gennartan/ergodox-rp2350/hardware/mechanical/README.md

# Hardware

This contains the STL files for the right hand only. For the left hand PCB, simply mirror the design.

The original files comes from [PrintDox Ergodox Case by AGuyFromOhio][https://www.thingiverse.com/thing:2533064]. These were modified to increase the holes size of the USB and completely match this project hardware.
