gennartan/ergodox-rp2350/docs/keyboard-configuration.md

# Keyboard configuration formats

The USB-connected half is the master. It owns a configuration for both hands,
resolves actions, and produces HID reports. The slave sends raw hand/key-index
press and release events over UART; it does not load or interpret a layout.
There is no configuration synchronization between halves. If the USB cable is
moved to the other half, that half uses its own saved configuration or factory
fallback.

## RAM

`struct keyboard_config` owns a name, an active layer count (1–8), a default
layer, a saved display-locale identifier, eight macro slots, and a fixed `actions[2][8][38]` table. `struct keyboard_layout` is a
read-only view into that RAM. The table uses 2,432 bytes, and the complete owned
configuration uses 3,122 bytes on the target.

Each naturally aligned action uses four bytes:

| Field | Size | Meaning |
| --- | --- | --- |
| type | 1 byte | Explicit action ID, 0–12 |
| modifier | 1 byte | Keyboard modifier mask; zero for other action types |
| payload | 2 bytes | Keycode, usage, mouse deltas, or target layer |

The master loads and validates once before scanning keys or accepting slave
events. A press checks active layers from highest to lowest, with at most eight
direct table lookups. The selected four-byte action is cached until release, so
releasing a layer key before another key does not change that key's release
behavior. HID aggregation retains the existing fixed scans over 76 key slots.
There is no allocation, decoding, CRC calculation, NVM access, or configuration
store mutex in the key-event path. Hardware latency has not been benchmarked.

The four named factory layers remain defaults; the runtime accepts all eight
layer slots. The C layout files provide a factory fallback rather than the live
runtime table. The offline configurator's C export remains usable for generating
factory defaults.

## NVM binary record, versions 1–5

This is an explicit byte encoding, not a dump of a C structure. All multibyte
integers are little-endian. Signed mouse deltas use two's-complement bytes.
Saves use version 5, including the macro bank and a 128-byte display-locale
trailer. Versions 1–4 remain readable. Locale metadata is restored from versions
2/3; versions 1/4 default to `qwerty`. Older firmware rejects version-5 records,
so export JSON before downgrading firmware.
Unknown versions are rejected.

| Header offset | Size | Field |
| --- | --- | --- |
| 0 | 4 | ASCII magic `EKCF` |
| 4 | 2 | Format version: 1–5 |
| 6 | 2 | Header size, 64 |
| 8 | 4 | Total record length, including header |
| 12 | 1 | Active layer count, 1–8 |
| 13 | 1 | Default layer index, less than layer count |
| 14 | 1 | Hand count, exactly 2 |
| 15 | 1 | Keys per hand, exactly 38 |
| 16 | 32 | NUL-terminated name, at most 31 bytes |
| 48 | 12 | Reserved, zero in versions 1/4/5; 12-byte locale identifier in versions 2/3 |
| 60 | 4 | IEEE CRC-32 of the entire record, treating this field as zero |
| 64 | variable | Four-byte actions, ordered by hand, active layer, key index |

Hand 0 is left; hand 1 is right. Only active layers are serialized. An action is
`[type, modifier, payload0, payload1]`:

| Type | ID | Payload bytes |
| --- | --- | --- |
| Transparent | 0 | `0, 0` |
| None | 1 | `0, 0` |
| Keyboard | 2 | `keycode, 0`; modifiers are in byte 1 |
| Consumer | 3 | 16-bit usage, little-endian |
| System | 4 | 16-bit usage, little-endian |
| Mouse buttons | 5 | 16-bit button mask, little-endian |
| Mouse move | 6 | signed X, signed Y |
| Mouse wheel | 7 | `0`, signed wheel delta |
| Lighting | 8 | 16-bit lighting command, little-endian |
| Momentary layer | 9 | `0`, target layer |
| Toggle layer | 10 | `0`, target layer |
| Default layer | 11 | `0`, target layer |
| Macro | 12 | 16-bit macro slot index, little-endian (versions 3–5 only) |

Unused action fields must be zero. Validation checks action types, supported HID
usage ranges, mouse ranges, lighting commands, and layer references. The maximum
version-5 record size is **3,168 bytes**; four layers use **1,952 bytes**.
Versions 3/4 omit the 128-byte locale trailer; versions 1/2 omit both the
locale trailer and the 544-byte macro bank. Malformed data
never partially replaces the RAM configuration.

Versions 3–5 append a fixed 544-byte macro bank after the actions: eight slots of
68 bytes each. A slot starts with a one-byte step count (0–16) and three zero
reserved bytes, followed by sixteen four-byte steps. A step is
`[modifier, keycode, delay_ms_low, delay_ms_high]`. Unused steps must be zero.
Keys are HID usages 0–101; modifiers are the usual eight-bit keyboard mask;
delays are 0–5,000 ms. An action may only reference a nonempty slot.

Version 5 then appends a fixed 128-byte NUL-terminated display-locale identifier
(up to 127 ASCII characters). Identifiers are lowercase filename stems from the
repository, using letters, digits, underscores or hyphens, starting with a letter
or digit. The default is `qwerty`. This identifier affects only the configurator's
labels; locale documents are not stored in flash and HID behavior is unchanged.

## Macro execution and editing

Left-click a key, choose **Macro (key sequence)**, and select one of eight shared
slots. Add, remove, or reorder up to sixteen taps using the mouse. Each tap has a
key, modifier checkboxes, and an optional delay after release. Apply to preview
and save to keyboard as usual. Editing a slot affects every key that
references it; Cancel or Discard preview does not alter the active configuration.

A macro runs once per physical press, continues after its trigger is released,
and does not repeat while held. Other macro triggers are ignored while one is
running. The executor sends an initial empty keyboard report, then a press and
release for each tap (at least 10 ms between transitions), plus the configured
after-release delay. A zero key with no modifiers can be used as a pause.
Physical keyboard keys/modifiers are temporarily excluded from keyboard reports
while the macro runs; physical state changes are still tracked, and the current
state is restored afterward. A key held across that restoration can register a
new press. Mouse and consumer/system actions continue normally. Failed HID sends
retry the same transition; an unavailable USB interface cancels the macro.
The executor uses delayed work, so delays do not sleep in key-event processing.
Macro output uses the computer's active keyboard locale, just like ordinary keys.

## Flash storage and boot behavior

The application image is limited to `0x000000..0x3fbfff`. A dedicated 16 KiB
`keyboard-config` partition occupies flash offsets `0x3fc000..0x3fffff`, within
the first 4 MiB. These are offsets in the flash device, not CPU addresses.
The board's other image/storage partitions remain untouched.

Zephyr NVS stores the whole binary configuration under record ID 1, across four
4 KiB sectors. The maximum blob fits in one sector with NVS metadata. NVS appends
a record and completes its metadata after writing its data; it also handles
sector recycling and skips unchanged writes. The application CRC covers both
configuration metadata and actions. This avoids a filesystem, per-key records,
and application-managed multi-record transactions.

On master boot or configuration-mode entry:

1. Copy and validate the compiled factory configuration into RAM.
2. Mount NVS and try to load/decode its configuration record.
3. Use the factory configuration if storage is absent, invalid, corrupt, or has
   an unsupported format. Log the reason through RTT.
4. In normal master mode, initialize the runtime with the validated RAM view
   before enabling split reception and GPIO scanning.

`keyboard_config_save()` validates and persists a complete candidate for the
next boot. It is permitted only in configuration mode. It does not replace the
live RAM table, and the web interface uses it for explicit JSON imports. See
[human-readable layout files](layout-json.md).
A save that is interrupted before NVS commits can leave the previous committed
record available; malformed committed records fall back to factory defaults.
Power interruption on physical RP2350 flash still needs hardware testing.

A regular UF2 image does not include the reserved configuration partition, so
reflashing can preserve saved data. A chip erase clears it. Firmware changes
that alter the binary meaning should bump the version and explicitly define compatibility or use the fallback.

## Web viewer and layout transfer

The configurator serves `GET /api/layout` as `application/octet-stream`, using
exactly the binary format above. The response is a snapshot of the active RAM
configuration, not a freshly read NVM record or a saved candidate awaiting
reboot. It is encoded once when configuration mode starts and served as a static
resource, allowing concurrent reads without modifying configuration state.
Viewing uses GET; validated uploads use the separate `POST /api/layout/import`
endpoint described in [the JSON format documentation](layout-json.md).

The maintained HTML, CSS, and JavaScript sources are bundled into a single gzip
HTML response at build time. The page and layout snapshot each need only one request, so a missing stylesheet
cannot leave the keyboard unstyled. Display-label downloads are optional external
requests and do not block loading the saved configuration or live key display. Live key polling then uses the separate
small endpoint described below.
A data-URI favicon avoids an extra automatic request. HTTP capacity supports six
clients, with socket polling sized for all clients plus the listener and eventfd;
network connection/context budgets also include DHCP. TCP windows are capped at
2 KiB per connection within the shared packet-buffer budget.

The embedded HTML/CSS/JavaScript viewer validates the record length, version,
dimensions, and CRC before displaying it. It shows the layout name, default layer,
all available layers, and both physical keyboard halves. Left-clicking a key opens an action editor. Choose the key type and its settings
using dropdowns and modifier/button checkboxes; no keyboard input is needed.
Apply to preview stages the assignment on the selected hand and layer. Cancel
closes the editor without changes. Save to keyboard persists the preview for
the next reboot, and Discard preview restores the current layout. All thirteen
action types are supported, including modifier-only keys and layer switching. Transparent assignments remain explicitly transparent rather
than pretending to resolve all possible combinations of active layers.
The selected display locale is part of the configuration, JSON export, and NVM.
Changing it creates a preview; **Save to keyboard** persists it for the next
reboot. Opening the configurator reads the identifier from the keyboard, so the
same selection is restored on a different computer. Browser preferences never
override the saved selection. Discard preview restores the current locale too.
The browser downloads the GitHub repository tree at revision
`8a391fd41a2b2b77cfab16d7f2e53da09bfe747a` of
[gennartan/layouts](https://github.com/gennartan/layouts) and builds the dropdown
from the available JSON files. Optional `tools/xkb-catalog.tsv` metadata provides
human-readable XKB names. There is no embedded list of locales; inheritance
helpers are excluded from the selector. At this revision there are 710 choices.
Only the chosen mapping and its parents are downloaded; the catalog and mappings
are cached by repository/revision for offline reuse. Downloads go directly from
the browser to GitHub over HTTPS. GitHub API limits, network failures, or unknown
saved identifiers leave the saved preference intact and show US HID fallback
labels with a retry button. If descriptions fail, filename-derived names remain
available. Blocked/full browser storage still allows use within the open page.
Locale documents and the catalog are never bundled in firmware.
Unmodified printable keyboard actions show keycap legends from the repository's
character compositions: base at lower left, Shift at upper left, AltGr at lower
right, and Shift+AltGr at upper right. Parent aliases for remapped positions are
removed before resolving inherited compositions, so an obsolete US symbol is
not shown on a locale-specific key. Only available mappings are drawn; a dotted
underline identifies dead-key accents. Multi-key composed characters and IME
output are not treated as single-key glyphs. Assigned modifier combinations,
modifier-only keys, and special actions keep centered action labels. Tooltips,
key details, and accessible names include the available character levels.
The browser cache includes legends and uses a new schema key, so existing
base-label-only caches are downloaded again once.
The host keyboard language still determines the typed characters.
The physical indices match the offline configurator's geometry.

## Live physical key display

Configuration mode starts the same debounced GPIO scanner as normal keyboard
mode and receives slave events over UART. It routes both to a separate ISR-safe
pressed-key bitmap, bypassing layer interpretation, lighting actions, and HID
report submission. Initial local levels capture a boot chord that is still held.
The slave continues its normal raw-event forwarding; it must not enter
configuration mode itself.

`GET /api/keys` returns a fresh 10-byte `application/octet-stream` snapshot with
`Cache-Control: no-store`. Bit `hand * 38 + key_index` indicates a pressed key,
least-significant bit first. Hand 0 is left; hand 1 is right. The last four bits
are zero. A short spinlock protects updates and the snapshot copy; the HTTP
response uses a separate buffer, so input interrupts cannot modify a response
while it is being sent. No configuration or flash writes are involved.

The browser updates only CSS classes and polls at up to 20 Hz, with at most one
request outstanding. It keeps physical highlights when switching the displayed
layer. Hidden tabs cancel polling and resume with a new snapshot when visible.
Errors or malformed responses clear stale highlights and retry with a delay of
250 ms, doubling up to 2 seconds. Snapshot polling can miss a tap shorter than
the interval between successful samples. UART event loss and reconnect-state
synchronization are not addressed by this HTTP snapshot API.

## Tests

Run the codec/runtime and real NVS backend tests using Zephyr's native simulator:

```sh
docker compose run --rm build west build -b native_sim/native/64 \
  -d /workspace/build/config-tests /workspace/tests/config
docker compose run --rm build sh -c \
  'cd /workspace/build/config-tests && ./zephyr/zephyr.exe'
```

Tests cover round trips, every single-byte corruption, truncation, invalid
configuration values, all eight layers, cross-hand layer resolution, release
semantics, saves/reloads, repeated writes that force NVS sector recycling,
write rejection during normal keyboard mode, and corrupt-record fallback.

With Node.js installed, test the browser decoder, action labels, physical key
indices, and invalid responses:

```sh
node tests/config/test_viewer.js
node tests/config/test_display_layouts.js
node tests/config/test_key_legends.js
```

Verify that the firmware page includes all its assets and runs its inline script
after the document is ready:

```sh
python3 tests/config/test_web_bundle.py
```

Test human-readable JSON interchange and strict validation:

```sh
node tests/config/test_json.js
node tests/config/test_macros.js
```

Exercise the upload callback with fragmented HTTP/1.1 bodies, captured headers,
and completion/abort resets (requires a host C compiler):

```sh
python3 tests/config/test_upload.py
python3 tests/config/test_macro_worker.py
```
