gennartan/ergodox-rp2350/hardware/electronic/production/v1/LeftHand/LeftHand_bom.csv

Designator | Footprint | Quantity | Value | LCSC Part #
C1, C16, C2, C3 | 0402 | 4 | 4.7u | C23733
C10, C11, C12, C13, C14, C15, C17, C18, C19, C6, C7, C8, C9 | 0402 | 13 | 100n | C1525
C20, C21 | 0402 | 2 | 15p | C1548
C4, C5 | 1206 | 2 | 10u | C13585
H99 | ErgoDOXmech | 1 | MECHANICAL
J1, J2 | USB_C_Receptacle_GCT_USB4105-xx-A_16P_TopMnt_Horizontal | 2 | USB_C_Receptacle_USB2.0_16P | C3025063
J3, J5 | PinSocket_1x03_P2.54mm_Horizontal | 2 | Conn_01x03_Pin | C92159
J4 | JST_SH_SM03B-SRSS-TB_1x03-1MP_P1.00mm_Horizontal | 1 | Conn_01x03_MountingPin | C160403
L1 | 0805 | 1 | 3.3u | C1046
R1, R4, R5 | 0402 | 3 | 33 | C25105
R10, R8, R9 | 0402 | 3 | 1k | C11702
R11, R12, R13, R14, R15, R16, R17, R18, R19, R20, R21, R22, R23, R24, R25, R26, R27, R28, R29, R30, R31, R32, R33, R34, R35, R36, R37, R38, R39, R40, R41, R42, R43, R44, R45, R46, R47, R48 | 0402 | 38 | 10k
R2, R3 | 0402 | 2 | 5.1k | C25905
R6 | 0402 | 1 | 0 | C17168
SW1, SW2 | SW_SMD_5x3mm | 2 | SW_Push | C720477
SW10, SW11, SW12, SW13, SW14, SW15, SW16, SW17, SW18, SW19, SW20, SW21, SW22, SW23, SW24, SW25, SW26, SW27, SW28, SW29, SW3, SW30, SW31, SW32, SW33, SW34, SW35, SW36, SW37, SW38, SW39, SW4, SW40, SW5, SW6, SW7, SW8, SW9 | MyCherrySwitch | 38 | SW_Push
U1 | QFN-80-1EP_10x10mm_P0.4mm_EP3.4x3.4mm_ThermalVias | 1 | RP2350B-QFN80 | C42415655
U2 | SOT-223-3_TabPin2 | 1 | NCP1117-3.3_SOT223 | C6186
U3 | SOIC-8_5.3x5.3mm_P1.27mm | 1 | W25Q128JVS | C97521
Y1 | Crystal_SMD_Abracon_ABM8G-4Pin_3.2x2.5mm | 1 | Crystal_GND24 | C20625731
