gennartan/ergodox-rp2350/hardware/mechanical/righthand_plate_2.stl

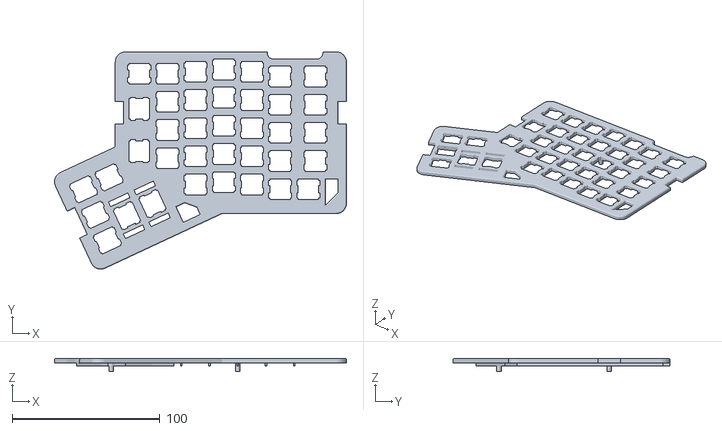
[picture p5: CAD file, 2026-06-07]
hardware/mechanical/righthand_plate_2.stl
197.5 x 146.9 x 8.70
