gennartan/ergodox-rp2350/hardware/mechanical/righthand_top_2.stl

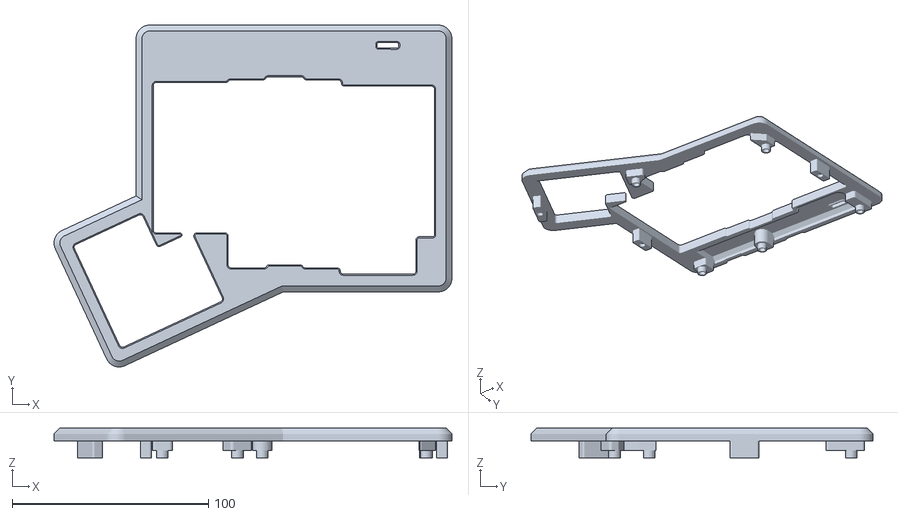
[picture p6: CAD file, 2026-06-07]
hardware/mechanical/righthand_top_2.stl
202.8 x 174.3 x 15.2
