gennartan/ergodox-rp2350/tests/config/fixtures/hid-io/README.md

JSON files and MIT license from https://github.com/gennartan/layouts
Revision: 8a391fd41a2b2b77cfab16d7f2e53da09bfe747a

Test fixtures only; never bundled in firmware.

`repository-tree.json` is the GitHub tree response at this revision. The XKB
catalog, inheritance helpers and representative XKB variants exercise dynamic
discovery and long locale identifiers. Fixtures are never bundled in firmware.
