gennartan/ergodox-rp2350/hardware/electronic/LeftHand.kicad_pcb

## KiCad design hardware/electronic/LeftHand.kicad_pcb (2026-06-07)

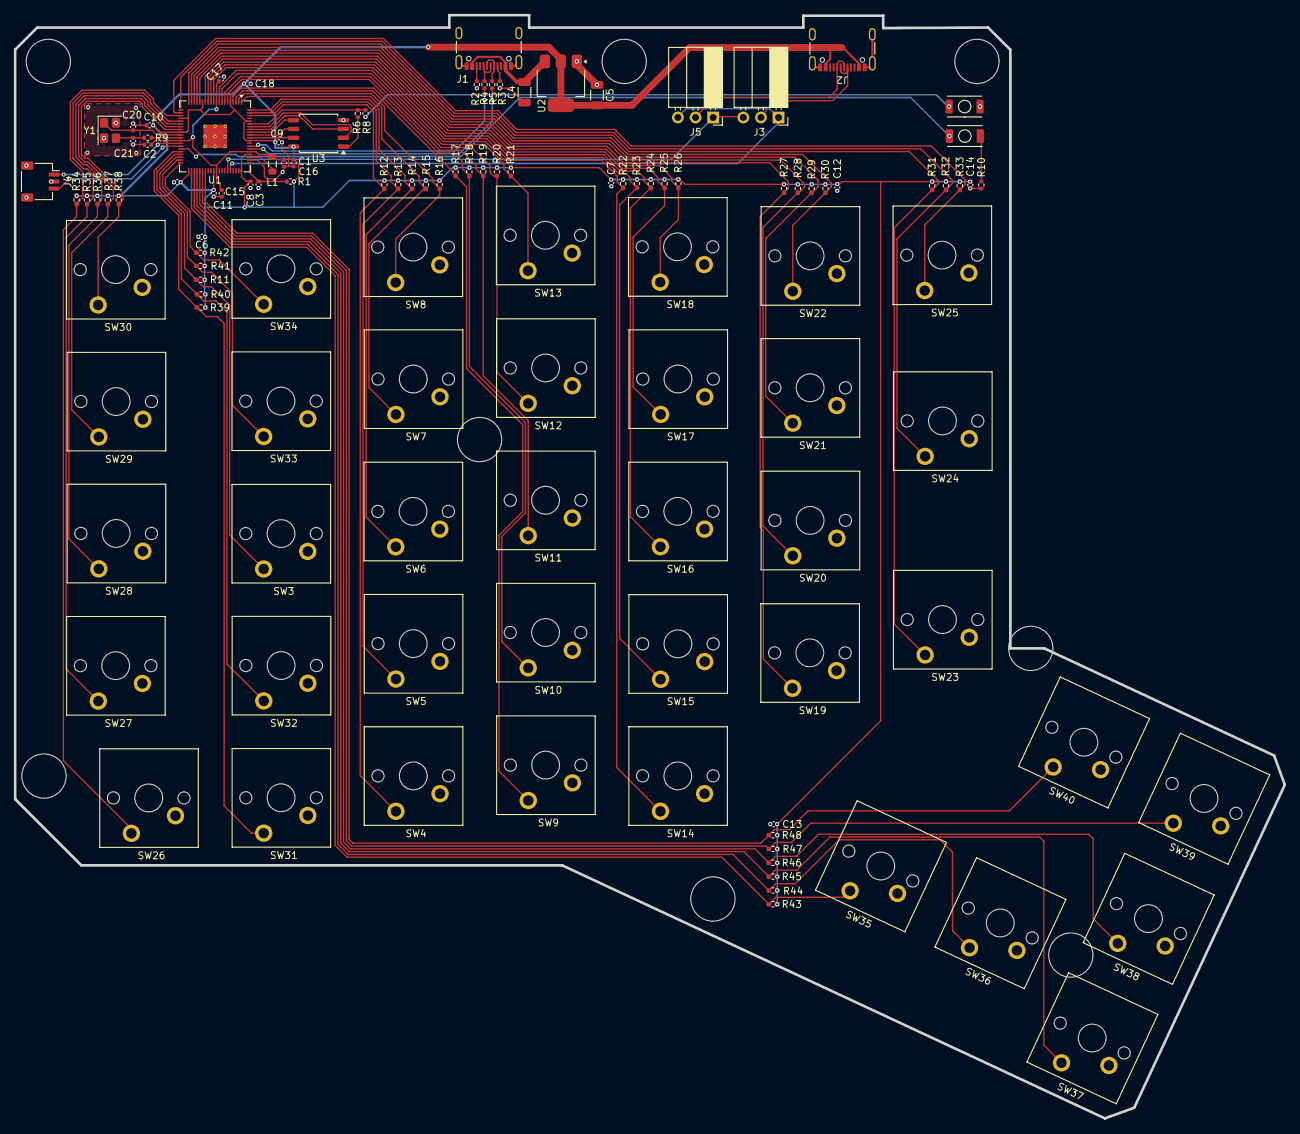
[picture p8: board LeftHand.kicad_pcb from above]

Board: 2 copper layers, 182.8 x 158.9 mm, 119 parts (1 on the bottom side), 69 nets.

Parts:
C1, C2, C3, C16: 4.7u; C_0402_1005Metric
C4, C5: 10u; C_1206_3216Metric
C6, C7, C8, C9, C10, C11, C12, C13, C14, C15, C17, C18, C19: 100n; C_0402_1005Metric
C20, C21: 15p; C_0402_1005Metric
H99: MECHANICAL; ErgoDOXmech
J1, J2: USB_C_Receptacle_USB2.0_16P; USB_C_Receptacle_GCT_USB4105-xx-A_16P_TopMnt_Horizontal
J3, J5: Conn_01x03_Pin; PinSocket_1x03_P2.54mm_Horizontal
J4: Conn_01x03_MountingPin; JST_SH_SM03B-SRSS-TB_1x03-1MP_P1.00mm_Horizontal
L1: 3.3u; L_0805_2012Metric
R1, R4, R5: 33; R_0402_1005Metric
R2, R3: 5.1k; R_0402_1005Metric
R6: 0; R_0402_1005Metric
R8, R9, R10: 1k; R_0402_1005Metric
R11, R12, R13, R14, R15, R16, R17, R18, R19, R20, R21, R22, R23, R24, R25, R26, R27, R28, R29, R30, R31, R32, R33, R34, R35, R36, R37, R38, R39, R40, R41, R42, R43, R44, R45, R46, R47, R48: 10k; R_0402_1005Metric_Pad0.72x0.64mm_HandSolder
SW1, SW2: SW_Push; SW_SMD_5x3mm
SW3, SW4, SW5, SW6, SW7, SW8, SW9, SW10, SW11, SW12, SW13, SW14, SW15, SW16, SW17, SW18, SW19, SW20, SW21, SW22, SW23, SW24, SW25, SW26, SW27, SW28, SW29, SW30, SW31, SW32, SW33, SW34, SW35, SW36, SW37, SW38, SW39, SW40: SW_Push; MyCherrySwitch
U1: RP2350B-QFN80; QFN-80-1EP_10x10mm_P0.4mm_EP3.4x3.4mm_ThermalVias
U2: NCP1117-3.3_SOT223; SOT-223-3_TabPin2
U3: W25Q128JVS; SOIC-8_5.3x5.3mm_P1.27mm
Y1: Crystal_GND24; Crystal_SMD_Abracon_ABM8G-4Pin_3.2x2.5mm

Connections:
+1V1: C2.1, C15.1, C16.1, C17.1, L1.1, U1.10 (DVDD), U1.32 (DVDD), U1.51 (DVDD), U1.65 (VREG_FB)
+3.3V: C1.1, C5.2, C6.1, C7.1, C8.1, C9.1, C10.1, C11.1, C12.1, C13.1, C14.1, C18.1, C19.1, J2.A4 (VBUS), J2.A9 (VBUS), J2.B4 (VBUS), J2.B9 (VBUS), R1.1, R11.1, R12.1, R13.1, R14.1, R15.1, R16.1, R17.1, R18.1, R19.1, R20.1, R21.1, R22.1, R23.1, R24.1, R25.1, R26.1, R27.1, R28.1, R29.1, R30.1, R31.1, R32.1, R33.1, R34.1, R35.1, R36.1, R37.1, R38.1, R39.1, R40.1, R41.1, R42.1, R43.1, R44.1, R45.1, R46.1, R47.1, R48.1, U1.5 (IOVDD), U1.15 (IOVDD), U1.24 (IOVDD), U1.29 (IOVDD), U1.41 (IOVDD), U1.50 (IOVDD), U1.59 (ADC_AVDD), U1.60 (IOVDD), U1.64 (VREG_VIN), U1.68 (USB_OTP_VDD), U1.69 (QSPI_IOVDD), U1.76 (IOVDD), U2.2 (VO), U3.8 (VCC)
/Flash Memory/QSPI_CLK: U1.71 (QSPI_SCLK), U3.6 (CLK)
/Flash Memory/QSPI_SD0: U1.72 (QSPI_SD0), U3.5 (DI/IO_{0})
/Flash Memory/QSPI_SD1: U1.74 (QSPI_SD1), U3.2 (DO/IO_{1})
/Flash Memory/QSPI_SD2: U1.73 (QSPI_SD2), U3.3 (~WP/IO_{2})
/Flash Memory/QSPI_SD3: U1.70 (QSPI_SD3), U3.7 (~HOLD/~RESET/IO_{3})
/Flash Memory/QSPI_SS: R6.1, R8.2, U1.75 (QSPI_SS)
/GPIO1: R12.2, SW4.2, U1.78 (GPIO1)
/GPIO2: R13.2, SW5.2, U1.79 (GPIO2)
/GPIO3: R14.2, SW6.2, U1.80 (GPIO3)
/GPIO4: R15.2, SW7.2, U1.1 (GPIO4)
/GPIO5: R16.2, SW8.2, U1.2 (GPIO5)
/GPIO6: R17.2, SW9.2, U1.3 (GPIO6)
/GPIO7: R18.2, SW10.2, U1.4 (GPIO7)
/GPIO8: R19.2, SW11.2, U1.6 (GPIO8)
/GPIO9: R20.2, SW12.2, U1.7 (GPIO9)
/GPIO10: R21.2, SW13.2, U1.8 (GPIO10)
/GPIO11: R22.2, SW14.2, U1.9 (GPIO11)
/GPIO12: R23.2, SW15.2, U1.11 (GPIO12)
/GPIO13: R24.2, SW16.2, U1.12 (GPIO13)
/GPIO14: R25.2, SW17.2, U1.13 (GPIO14)
/GPIO15: R26.2, SW18.2, U1.14 (GPIO15)
/GPIO16: R27.2, SW19.2, U1.16 (GPIO16)
/GPIO17: R28.2, SW20.2, U1.17 (GPIO17)
/GPIO18: R29.2, SW21.2, U1.18 (GPIO18)
/GPIO19: R30.2, SW22.2, U1.19 (GPIO19)
/GPIO20: R31.2, SW23.2, U1.20 (GPIO20)
/GPIO21: R32.2, SW24.2, U1.21 (GPIO21)
/GPIO22: R33.2, SW25.2, U1.22 (GPIO22)
/GPIO23: R34.2, SW26.2, U1.23 (GPIO23)
/GPIO24: R35.2, SW27.2, U1.25 (GPIO24)
/GPIO25: R36.2, SW28.2, U1.26 (GPIO25)
/GPIO26: R37.2, SW29.2, U1.27 (GPIO26)
/GPIO27: R38.2, SW30.2, U1.28 (GPIO27)
/GPIO28: R39.2, SW31.2, U1.36 (GPIO28)
/GPIO29: R40.2, SW32.2, U1.37 (GPIO29)
/GPIO30: R11.2, SW3.2, U1.38 (GPIO30)
/GPIO31: R41.2, SW33.2, U1.39 (GPIO31)
/GPIO32: R42.2, SW34.2, U1.40 (GPIO32)
/GPIO33: R43.2, SW35.2, U1.42 (GPIO33)
/GPIO34: R44.2, SW36.2, U1.43 (GPIO34)
/GPIO35: R45.2, SW37.2, U1.44 (GPIO35)
/GPIO36: R46.2, SW38.2, U1.45 (GPIO36)
/GPIO37: R47.2, SW39.2, U1.46 (GPIO37)
/GPIO38: R48.2, SW40.2, U1.47 (GPIO38)
/Power/VREG_AVDD: C3.2, R1.2, U1.61 (VREG_AVDD)
/Power/VREG_LX: L1.2, U1.63 (VREG_LX)
/RUN: SW2.2, U1.35 (RUN)
/SWCLK: J4.1, U1.33 (SWCLK)
/SWD: J4.3, U1.34 (SWDIO)
/USB_DN: R5.1, U1.66 (USB_DM)
/USB_DP: R4.1, U1.67 (USB_DP)
GND: C1.2, C2.2, C3.1, C4.1, C5.1, C6.2, C7.2, C8.2, C9.2, C10.2, C11.2, C12.2, C13.2, C14.2, C15.2, C16.2, C17.2, C18.2, C19.2, C20.1, C21.1, J1.A1 (GND), J1.A12 (GND), J1.B1 (GND), J1.B12 (GND), J1.S1 (SHIELD), J2.A1 (GND), J2.A12 (GND), J2.B1 (GND), J2.B12 (GND), J2.S1 (SHIELD), J4.2, J4.MP (MountPin), R2.2, R3.2, R10.2, SW1.1, SW3.1, SW4.1, SW5.1, SW6.1, SW7.1, SW8.1, SW9.1, SW10.1, SW11.1, SW12.1, SW13.1, SW14.1, SW15.1, SW16.1, SW17.1, SW18.1, SW19.1, SW20.1, SW21.1, SW22.1, SW23.1, SW24.1, SW25.1, SW26.1, SW27.1, SW28.1, SW29.1, SW30.1, SW31.1, SW32.1, SW33.1, SW34.1, SW35.1, SW36.1, SW37.1, SW38.1, SW39.1, SW40.1, U1.62 (VREG_PGND), U1.81 (GND), U2.1 (GND), U3.4 (GND), Y1.2, Y1.4
unnamed: C21.2, R9.1, Y1.3
unnamed: J1.A5 (CC1), R3.1
unnamed: J1.B5 (CC2), R2.1
unnamed: J2.A7 (D-), J2.B7 (D-), J3.2
unnamed: J2.A6 (D+), J2.B6 (D+), J5.2
unnamed: R8.1, SW1.2
unnamed: R10.1, SW2.1
unnamed: C20.2, U1.30 (XIN), Y1.1
unnamed: R9.2, U1.31 (XOUT)
unnamed: R6.2, U3.1 (~CS)
UART0_RX: J3.1, J5.3, U1.56 (GPIO45_ADC5)
UART0_TX: J3.3, J5.1, U1.55 (GPIO44_ADC4)
USB_D+: J1.A6 (D+), J1.B6 (D+), R4.2
USB_D-: J1.A7 (D-), J1.B7 (D-), R5.2
VBUS: C4.2, J1.A4 (VBUS), J1.A9 (VBUS), J1.B4 (VBUS), J1.B9 (VBUS), U2.3 (VI)
