gennartan/ergodox-rp2350/src/main.c

#include <string.h>

#include <zephyr/kernel.h>
#include <zephyr/device.h>
#include <zephyr/drivers/gpio.h>
#include <zephyr/usb/usbd.h>
#include <zephyr/usb/class/usbd_hid.h>
#include <zephyr/logging/log.h>

#include "configurator_mode.h"
#include "keyboard_layout.h"
#include "keyboard_config.h"
#include "keyboard_input_state.h"
#include "split_transport.h"

LOG_MODULE_REGISTER(kbd);

#define LEDS 4
#define LED0_NODE DT_ALIAS(led0)
#define LED1_NODE DT_ALIAS(led1)
#define LED2_NODE DT_ALIAS(led2)
#define LED3_NODE DT_ALIAS(led3)

static const struct gpio_dt_spec leds[LEDS] = {
    GPIO_DT_SPEC_GET(LED0_NODE, gpios),
    GPIO_DT_SPEC_GET(LED1_NODE, gpios),
    GPIO_DT_SPEC_GET(LED2_NODE, gpios),
    GPIO_DT_SPEC_GET(LED3_NODE, gpios),
};

#define KEY_DEBOUNCE_MS 5

// Individual key GPIOs for the electronic design
static const struct gpio_dt_spec keys[KEYBOARD_KEY_COUNT] = {
    GPIO_DT_SPEC_GET(DT_NODELABEL(key1), gpios),
    GPIO_DT_SPEC_GET(DT_NODELABEL(key2), gpios),
    GPIO_DT_SPEC_GET(DT_NODELABEL(key3), gpios),
    GPIO_DT_SPEC_GET(DT_NODELABEL(key4), gpios),
    GPIO_DT_SPEC_GET(DT_NODELABEL(key5), gpios),
    GPIO_DT_SPEC_GET(DT_NODELABEL(key6), gpios),
    GPIO_DT_SPEC_GET(DT_NODELABEL(key7), gpios),
    GPIO_DT_SPEC_GET(DT_NODELABEL(key8), gpios),
    GPIO_DT_SPEC_GET(DT_NODELABEL(key9), gpios),
    GPIO_DT_SPEC_GET(DT_NODELABEL(key10), gpios),
    GPIO_DT_SPEC_GET(DT_NODELABEL(key11), gpios),
    GPIO_DT_SPEC_GET(DT_NODELABEL(key12), gpios),
    GPIO_DT_SPEC_GET(DT_NODELABEL(key13), gpios),
    GPIO_DT_SPEC_GET(DT_NODELABEL(key14), gpios),
    GPIO_DT_SPEC_GET(DT_NODELABEL(key15), gpios),
    GPIO_DT_SPEC_GET(DT_NODELABEL(key16), gpios),
    GPIO_DT_SPEC_GET(DT_NODELABEL(key17), gpios),
    GPIO_DT_SPEC_GET(DT_NODELABEL(key18), gpios),
    GPIO_DT_SPEC_GET(DT_NODELABEL(key19), gpios),
    GPIO_DT_SPEC_GET(DT_NODELABEL(key20), gpios),
    GPIO_DT_SPEC_GET(DT_NODELABEL(key21), gpios),
    GPIO_DT_SPEC_GET(DT_NODELABEL(key22), gpios),
    GPIO_DT_SPEC_GET(DT_NODELABEL(key23), gpios),
    GPIO_DT_SPEC_GET(DT_NODELABEL(key24), gpios),
    GPIO_DT_SPEC_GET(DT_NODELABEL(key25), gpios),
    GPIO_DT_SPEC_GET(DT_NODELABEL(key26), gpios),
    GPIO_DT_SPEC_GET(DT_NODELABEL(key27), gpios),
    GPIO_DT_SPEC_GET(DT_NODELABEL(key28), gpios),
    GPIO_DT_SPEC_GET(DT_NODELABEL(key29), gpios),
    GPIO_DT_SPEC_GET(DT_NODELABEL(key30), gpios),
    GPIO_DT_SPEC_GET(DT_NODELABEL(key31), gpios),
    GPIO_DT_SPEC_GET(DT_NODELABEL(key32), gpios),
    GPIO_DT_SPEC_GET(DT_NODELABEL(key33), gpios),
    GPIO_DT_SPEC_GET(DT_NODELABEL(key34), gpios),
    GPIO_DT_SPEC_GET(DT_NODELABEL(key35), gpios),
    GPIO_DT_SPEC_GET(DT_NODELABEL(key36), gpios),
    GPIO_DT_SPEC_GET(DT_NODELABEL(key37), gpios),
    GPIO_DT_SPEC_GET(DT_NODELABEL(key38), gpios),
};

const uint8_t keyboard_hid_report_desc[] = ERGODOX_HID_REPORT_DESC();

static const struct device *keyboard_hid_dev;
static bool keyboard_hid_ready;
static atomic_t hid_protocol = ATOMIC_INIT(HID_PROTOCOL_REPORT);
static uint32_t hid_duration;

USBD_DEVICE_DEFINE(ergodox_usbd,
    DEVICE_DT_GET(DT_NODELABEL(zephyr_udc0)),
    0x2fe3, 0x0007);

USBD_DESC_LANG_DEFINE(ergodox_lang);
USBD_DESC_MANUFACTURER_DEFINE(ergodox_mfr, "Zephyr");
USBD_DESC_PRODUCT_DEFINE(ergodox_product, "Ergodox Custom Keyboard");
USBD_DESC_CONFIG_DEFINE(ergodox_fs_desc, "FS Configuration");
USBD_CONFIGURATION_DEFINE(ergodox_fs_config, 0, 50, &ergodox_fs_desc);

struct key_irq {
    struct gpio_callback callback;
    struct k_work_delayable work;
    uint8_t index;
};

static struct key_irq key_irqs[KEYBOARD_KEY_COUNT];
static struct keyboard_runtime keyboard;
static bool local_pressed[KEYBOARD_KEY_COUNT];
static struct k_spinlock runtime_lock;
static struct k_work split_events_work;
K_MSGQ_DEFINE(split_event_msgq, sizeof(struct split_key_event), 32, 4);

enum keyboard_transport_mode {
    KEYBOARD_TRANSPORT_USB,
    KEYBOARD_TRANSPORT_UART,
    KEYBOARD_TRANSPORT_CONFIGURATOR,
};

static enum keyboard_transport_mode transport_mode = KEYBOARD_TRANSPORT_UART;

#if IS_ENABLED(CONFIG_ERGODOX_KEYBOARD_HAND_LEFT)
#define ERGODOX_KEYBOARD_HAND KEYBOARD_HAND_LEFT
#define ERGODOX_KEYBOARD_HAND_NAME "left"
#else
#define ERGODOX_KEYBOARD_HAND KEYBOARD_HAND_RIGHT
#define ERGODOX_KEYBOARD_HAND_NAME "right"
#endif

UDC_STATIC_BUF_DEFINE(keyboard_hid_report, ERGODOX_HID_KEYBOARD_REPORT_SIZE);
UDC_STATIC_BUF_DEFINE(boot_keyboard_hid_report, KEYBOARD_HID_REPORT_SIZE);
UDC_STATIC_BUF_DEFINE(consumer_hid_report, ERGODOX_HID_CONSUMER_REPORT_SIZE);
UDC_STATIC_BUF_DEFINE(system_hid_report, ERGODOX_HID_SYSTEM_REPORT_SIZE);
UDC_STATIC_BUF_DEFINE(mouse_hid_report, ERGODOX_HID_MOUSE_REPORT_SIZE);

static bool lighting_enabled = true;
static struct k_work_delayable macro_work;
/* Key-event HID sends and macro scheduling run on the system work queue. */
static bool macro_report_pending;


static void kb_iface_ready(const struct device *dev, const bool ready)
{
	LOG_INF("HID device %s interface is %s",
		dev->name, ready ? "ready" : "not ready");

    if (ready) {
        atomic_set(&hid_protocol, HID_PROTOCOL_REPORT);
    }
    keyboard_hid_ready = ready;
}

static int kb_get_report(const struct device *dev,
			 const uint8_t type, const uint8_t id, const uint16_t len,
			 uint8_t *const buf)
{
	LOG_WRN("Get Report not implemented, Type %u ID %u", type, id);

	return 0;
}

static int kb_set_report(const struct device *dev,
			 const uint8_t type, const uint8_t id, const uint16_t len,
			 const uint8_t *const buf)
{
    LOG_WRN("Set Report not implemented, Type %u ID %u", type, id);
	return 0;
}

/* Idle duration is stored but not used to calculate idle reports. */
static void kb_set_idle(const struct device *dev,
			const uint8_t id, const uint32_t duration)
{
	LOG_INF("Set Idle %u to %u", id, duration);
	hid_duration = duration;
}

static uint32_t kb_get_idle(const struct device *dev, const uint8_t id)
{
	LOG_INF("Get Idle %u to %u", id, hid_duration);
	return hid_duration;
}

static void kb_set_protocol(const struct device *dev, const uint8_t proto)
{
    atomic_set(&hid_protocol, proto);
	LOG_INF("Protocol changed to %s",
		proto == 0U ? "Boot Protocol" : "Report Protocol");
}

static void kb_output_report(const struct device *dev, const uint16_t len,
			     const uint8_t *const buf)
{
	LOG_HEXDUMP_DBG(buf, len, "o.r.");
	kb_set_report(dev, HID_REPORT_TYPE_OUTPUT, 0U, len, buf);
}

struct hid_device_ops kb_ops = {
	.iface_ready = kb_iface_ready,
	.get_report = kb_get_report,
	.set_report = kb_set_report,
	.set_idle = kb_set_idle,
	.get_idle = kb_get_idle,
	.set_protocol = kb_set_protocol,
	.output_report = kb_output_report,
};

static void usbd_msg_cb(struct usbd_context *const usbd_ctx,
    const struct usbd_msg *const msg)
{
    LOG_INF("USBD message: %s", usbd_msg_type_string(msg->type));

    if (msg->type == USBD_MSG_CONFIGURATION) {
        LOG_INF("Configuration value %d", msg->status);
    }

    if (usbd_can_detect_vbus(usbd_ctx)) {
        if (msg->type == USBD_MSG_VBUS_READY) {
            if (usbd_enable(usbd_ctx)) {
                LOG_ERR("Failed to enable USB device support");
            }
        }

        if (msg->type == USBD_MSG_VBUS_REMOVED) {
            keyboard_hid_ready = false;
            if (usbd_disable(usbd_ctx)) {
                LOG_ERR("Failed to disable USB device support");
            }
        }
    }
}

static int init_usb_device(void)
{
    int ret;

    keyboard_hid_dev = DEVICE_DT_GET(DT_NODELABEL(hid_dev_0));
    if (!device_is_ready(keyboard_hid_dev)) {
        LOG_ERR("Keyboard HID device is not ready");
        return -ENODEV;
    }

    ret = hid_device_register(keyboard_hid_dev, keyboard_hid_report_desc,
        sizeof(keyboard_hid_report_desc), &kb_ops);
    if (ret != 0) {
        LOG_ERR("Failed to register keyboard HID device: %d", ret);
        return ret;
    }

    ret = usbd_add_descriptor(&ergodox_usbd, &ergodox_lang);
    if (ret != 0) {
        LOG_ERR("Failed to add language descriptor: %d", ret);
        return ret;
    }

    ret = usbd_add_descriptor(&ergodox_usbd, &ergodox_mfr);
    if (ret != 0) {
        LOG_ERR("Failed to add manufacturer descriptor: %d", ret);
        return ret;
    }

    ret = usbd_add_descriptor(&ergodox_usbd, &ergodox_product);
    if (ret != 0) {
        LOG_ERR("Failed to add product descriptor: %d", ret);
        return ret;
    }

    ret = usbd_add_configuration(&ergodox_usbd, USBD_SPEED_FS,
        &ergodox_fs_config);
    if (ret != 0) {
        LOG_ERR("Failed to add full-speed configuration: %d", ret);
        return ret;
    }

    /* The network function belongs exclusively to configurator boot mode. */
    static const char *const blocklist[] = { "cdc_ncm_0", NULL };

    ret = usbd_register_all_classes(&ergodox_usbd, USBD_SPEED_FS, 1, blocklist);
    if (ret != 0) {
        LOG_ERR("Failed to register USB classes: %d", ret);
        return ret;
    }

    ret = usbd_device_set_code_triple(&ergodox_usbd, USBD_SPEED_FS, 0, 0, 0);
    if (ret != 0) {
        LOG_ERR("Failed to set USB code triple: %d", ret);
        return ret;
    }

    ret = usbd_msg_register_cb(&ergodox_usbd, usbd_msg_cb);
    if (ret != 0) {
        LOG_ERR("Failed to register USB message callback: %d", ret);
        return ret;
    }

    ret = usbd_init(&ergodox_usbd);
    if (ret != 0) {
        LOG_ERR("Failed to initialize USB device support: %d", ret);
        return ret;
    }

    if (!usbd_can_detect_vbus(&ergodox_usbd)) {
        ret = usbd_enable(&ergodox_usbd);
        if (ret != 0) {
            LOG_ERR("Failed to enable USB device support: %d", ret);
            return ret;
        }
    }

    return 0;
}

static void update_leds_for_layers(void)
{
    k_spinlock_key_t key = k_spin_lock(&runtime_lock);
    uint32_t active_layers = keyboard_runtime_active_layers(&keyboard);

    k_spin_unlock(&runtime_lock, key);

    // Map layers to LEDs (BASE layer has no LED indicator)
    // Layer 0 (BASE) = all LEDs off
    // Layer 1 (NAV) = LED0 on
    // Layer 2 (SYMBOL) = LED1 on
    // Layer 3 (FN) = LED2 on
    for (int i = 0; i < LEDS; i++) {
        // Turn on LED if the corresponding layer (i+1) is active
        int led_state = lighting_enabled &&
            (active_layers & BIT(i + 1)) ? 1 : 0;
        gpio_pin_set_dt(&leds[i], led_state);
        LOG_INF("LED %d %s for layer %d", i, led_state ? "ON" : "OFF", i + 1);
    }
}

static int send_hid_report(const struct device *dev, bool ready,
    const uint8_t *report, size_t size)
{
    int ret;

    if (!ready) {
        LOG_DBG("USB HID interface %s is not ready", dev->name);
        return -ENODEV;
    }

    /* Boot hosts understand only the unnumbered eight-byte keyboard report. */
    if (atomic_get(&hid_protocol) == HID_PROTOCOL_BOOT &&
        report != boot_keyboard_hid_report) {
        return -ENODEV;
    }

    ret = hid_device_submit_report(dev, size, report);
    if (ret != 0) {
        LOG_ERR("Failed to submit HID report: %d", ret);
    }
    return ret;
}

static int submit_hid_report_from_runtime(void)
{
    k_spinlock_key_t key = k_spin_lock(&runtime_lock);

    keyboard_hid_report[0] = ERGODOX_HID_REPORT_ID_KEYBOARD;
    keyboard_runtime_build_hid_report(&keyboard, &keyboard_hid_report[1]);
    memcpy(boot_keyboard_hid_report, &keyboard_hid_report[1],
        KEYBOARD_HID_REPORT_SIZE);

    k_spin_unlock(&runtime_lock, key);
    if (atomic_get(&hid_protocol) == HID_PROTOCOL_BOOT) {
        return send_hid_report(keyboard_hid_dev, keyboard_hid_ready,
            boot_keyboard_hid_report, KEYBOARD_HID_REPORT_SIZE);
    } else {
        return send_hid_report(keyboard_hid_dev, keyboard_hid_ready,
            /* UDC buffers are padded for alignment; send only report bytes. */
            keyboard_hid_report, ERGODOX_HID_KEYBOARD_REPORT_SIZE);
    }
}

static void submit_consumer_report_from_runtime(void)
{
    k_spinlock_key_t key = k_spin_lock(&runtime_lock);
    uint16_t usage = keyboard_runtime_consumer_usage(&keyboard);

    consumer_hid_report[0] = ERGODOX_HID_REPORT_ID_CONSUMER;
    consumer_hid_report[1] = usage & 0xff;
    consumer_hid_report[2] = usage >> 8;
    k_spin_unlock(&runtime_lock, key);

    send_hid_report(keyboard_hid_dev, keyboard_hid_ready,
        consumer_hid_report, ERGODOX_HID_CONSUMER_REPORT_SIZE);
}

static void submit_system_report_from_runtime(void)
{
    k_spinlock_key_t key = k_spin_lock(&runtime_lock);

    system_hid_report[0] = ERGODOX_HID_REPORT_ID_SYSTEM;
    system_hid_report[1] = keyboard_runtime_system_usage(&keyboard);
    k_spin_unlock(&runtime_lock, key);

    send_hid_report(keyboard_hid_dev, keyboard_hid_ready,
        system_hid_report, ERGODOX_HID_SYSTEM_REPORT_SIZE);
}

static void submit_mouse_report_from_runtime(int8_t x, int8_t y, int8_t wheel)
{
    k_spinlock_key_t key = k_spin_lock(&runtime_lock);

    mouse_hid_report[0] = ERGODOX_HID_REPORT_ID_MOUSE;
    mouse_hid_report[1] = keyboard_runtime_mouse_buttons(&keyboard);
    mouse_hid_report[2] = (uint8_t)x;
    mouse_hid_report[3] = (uint8_t)y;
    mouse_hid_report[4] = (uint8_t)wheel;
    k_spin_unlock(&runtime_lock, key);

    send_hid_report(keyboard_hid_dev, keyboard_hid_ready,
        mouse_hid_report, ERGODOX_HID_MOUSE_REPORT_SIZE);
}

static void apply_lighting_action(uint16_t command)
{
    switch (command) {
    case KEYBOARD_LIGHTING_TOGGLE:
        lighting_enabled = !lighting_enabled;
        break;
    case KEYBOARD_LIGHTING_ON:
    case KEYBOARD_LIGHTING_BRIGHTNESS_UP:
        lighting_enabled = true;
        break;
    case KEYBOARD_LIGHTING_OFF:
    case KEYBOARD_LIGHTING_BRIGHTNESS_DOWN:
        lighting_enabled = false;
        break;
    default:
        return;
    }

    update_leds_for_layers();
}

static void macro_work_handler(struct k_work *work)
{
    ARG_UNUSED(work);
    if (!keyboard_hid_ready) {
        k_spinlock_key_t key = k_spin_lock(&runtime_lock);
        keyboard_runtime_macro_cancel(&keyboard);
        k_spin_unlock(&runtime_lock, key);
        macro_report_pending = false;
        return;
    }
    k_spinlock_key_t key = k_spin_lock(&runtime_lock);
    if (!macro_report_pending) { keyboard_runtime_macro_advance(&keyboard); }
    uint32_t delay = keyboard_runtime_macro_delay(&keyboard);
    bool active = keyboard.macro_phase != 0;
    k_spin_unlock(&runtime_lock, key);

    /* A failed send retries the same state, including the final restore report.
     * Advancing only after delivery prevents missing presses or stuck modifiers. */
    macro_report_pending = submit_hid_report_from_runtime() != 0;
    if (active || macro_report_pending) {
        k_work_reschedule(&macro_work, K_MSEC(macro_report_pending ? 10 : delay));
    }
}

static void process_key_event(const struct split_key_event *event)
{
    struct keyboard_action action;
    uint32_t active_layers;
    bool pressed;
    bool report_changed;

    if (event->hand >= KEYBOARD_HAND_COUNT ||
        event->key_index >= KEYBOARD_KEY_COUNT) {
        return;
    }

    if (event->type == SPLIT_KEY_EVENT_DOUBLE_TAP) {
        struct split_key_event press = *event;
        struct split_key_event release = *event;

        press.type = SPLIT_KEY_EVENT_PRESS;
        release.type = SPLIT_KEY_EVENT_RELEASE;
        process_key_event(&press);
        process_key_event(&release);
        process_key_event(&press);
        process_key_event(&release);
        return;
    }

    switch (event->type) {
    case SPLIT_KEY_EVENT_PRESS:
        pressed = true;
        break;
    case SPLIT_KEY_EVENT_RELEASE:
        pressed = false;
        break;
    default:
        LOG_WRN("Unsupported split key event type %u", event->type);
        return;
    }

    k_spinlock_key_t key = k_spin_lock(&runtime_lock);

    report_changed = keyboard_runtime_handle_key(&keyboard, event->hand,
        event->key_index, pressed);
    action = *keyboard_runtime_pressed_action(&keyboard, event->hand,
        event->key_index);
    active_layers = keyboard_runtime_active_layers(&keyboard);
    bool macro_active = keyboard.macro_phase != 0;

    k_spin_unlock(&runtime_lock, key);

    if (pressed && action.type == KEYBOARD_ACTION_LIGHTING) {
        apply_lighting_action(action.usage);
    } else {
        update_leds_for_layers();
    }

    if (report_changed) {
        switch (action.type) {
        case KEYBOARD_ACTION_MACRO:
            macro_report_pending = true;
            k_work_reschedule(&macro_work, K_NO_WAIT);
            break;
        case KEYBOARD_ACTION_KEY:
            if (!macro_active) { submit_hid_report_from_runtime(); }
            break;
        case KEYBOARD_ACTION_CONSUMER:
            submit_consumer_report_from_runtime();
            break;
        case KEYBOARD_ACTION_SYSTEM:
            submit_system_report_from_runtime();
            break;
        case KEYBOARD_ACTION_MOUSE_BUTTON:
            submit_mouse_report_from_runtime(0, 0, 0);
            break;
        case KEYBOARD_ACTION_MOUSE_MOVE:
            submit_mouse_report_from_runtime(action.x, action.y, 0);
            break;
        case KEYBOARD_ACTION_MOUSE_WHEEL:
            submit_mouse_report_from_runtime(0, 0, action.y);
            break;
        default:
            break;
        }
    }

    LOG_INF("Key %s: hand %u, index %d, keycode 0x%02x, layers 0x%08x",
        pressed ? "pressed" : "released", event->hand, event->key_index + 1,
        action.keycode, active_layers);
}

static void split_events_work_handler(struct k_work *work)
{
    struct split_key_event event;

    ARG_UNUSED(work);

    while (k_msgq_get(&split_event_msgq, &event, K_NO_WAIT) == 0) {
        process_key_event(&event);
    }
}

static void split_events_received(const struct split_key_event *events,
    uint8_t count, void *user_data)
{
    ARG_UNUSED(user_data);

    if (transport_mode == KEYBOARD_TRANSPORT_CONFIGURATOR) {
        /* UART callback runs in interrupt context: record bits, never send HID. */
        for (uint8_t i = 0; i < count; i++) {
            keyboard_input_state_handle(&events[i]);
        }
        return;
    }

    for (uint8_t i = 0; i < count; i++) {
        if (k_msgq_put(&split_event_msgq, &events[i], K_NO_WAIT) != 0) {
            LOG_WRN("Dropped split key event");
        }
    }

    k_work_submit(&split_events_work);
}

static bool wait_for_usb_ready(void)
{
    int64_t deadline = k_uptime_get() + CONFIG_ERGODOX_USB_READY_TIMEOUT_MS;

    while (k_uptime_get() < deadline) {
        if (keyboard_hid_ready) {
            return true;
        }

        k_msleep(10);
    }

    return keyboard_hid_ready;
}

static int publish_key_event(uint8_t index, bool pressed)
{
    struct split_key_event event = {
        .hand = ERGODOX_KEYBOARD_HAND,
        .key_index = index,
        .type = pressed ? SPLIT_KEY_EVENT_PRESS : SPLIT_KEY_EVENT_RELEASE,
    };

#if IS_ENABLED(CONFIG_ERGODOX_SPLIT_UART)
    return split_transport_send_event(&event);
#else
    ARG_UNUSED(event);
    return -ENOTSUP;
#endif
}

static void update_key(uint8_t index, bool pressed)
{
    struct split_key_event event = {
        .hand = ERGODOX_KEYBOARD_HAND,
        .key_index = index,
        .type = pressed ? SPLIT_KEY_EVENT_PRESS : SPLIT_KEY_EVENT_RELEASE,
    };
    int ret;

    if (index >= KEYBOARD_KEY_COUNT || pressed == local_pressed[index]) {
        return;
    }

    local_pressed[index] = pressed;

    if (transport_mode == KEYBOARD_TRANSPORT_CONFIGURATOR) {
        keyboard_input_state_handle(&event);
        return;
    }
    if (transport_mode == KEYBOARD_TRANSPORT_USB) {
        process_key_event(&event);
        return;
    }

    ret = publish_key_event(index, pressed);
    if (ret != 0) {
        LOG_WRN("Failed to publish local key event: %d", ret);
    }
}

static void key_work_handler(struct k_work *work)
{
    struct k_work_delayable *dwork = k_work_delayable_from_work(work);
    struct key_irq *key_irq = CONTAINER_OF(dwork, struct key_irq, work);
    int pressed = gpio_pin_get_dt(&keys[key_irq->index]);

    if (pressed < 0) {
        LOG_ERR("Failed to read key %u: %d", key_irq->index + 1, pressed);
        return;
    }
    update_key(key_irq->index, pressed != 0);
}

static void key_gpio_callback(const struct device *port,
    struct gpio_callback *callback, gpio_port_pins_t pins)
{
    struct key_irq *key_irq = CONTAINER_OF(callback, struct key_irq, callback);

    ARG_UNUSED(port);
    ARG_UNUSED(pins);

    k_work_reschedule(&key_irq->work, K_MSEC(KEY_DEBOUNCE_MS));
}

static int init_split_transport(bool receive_events)
{
#if IS_ENABLED(CONFIG_ERGODOX_SPLIT_UART)
    return split_transport_init(receive_events ? split_events_received : NULL,
        NULL);
#else
    ARG_UNUSED(receive_events);
    return 0;
#endif
}

static int select_transport_mode(void)
{
    int ret = init_usb_device();

    if (ret == 0 && wait_for_usb_ready()) {
        transport_mode = KEYBOARD_TRANSPORT_USB;
        /* Load once before enabling local scans or processing slave events. */
        ret = keyboard_config_init(false);
        if (ret != 0) {
            return ret;
        }
        keyboard_runtime_init(&keyboard, keyboard_config_layout());
        LOG_INF("Master layout: %s, hand: %s", keyboard.layout->name,
            ERGODOX_KEYBOARD_HAND_NAME);
        LOG_INF("Using USB HID to host and UART for split RX");
        return init_split_transport(true);
    }

    if (ret != 0) {
        LOG_WRN("USB initialization failed, falling back to UART: %d", ret);
    } else {
        LOG_WRN("USB HID not ready after %d ms, falling back to UART",
            CONFIG_ERGODOX_USB_READY_TIMEOUT_MS);
        (void)usbd_disable(&ergodox_usbd);
    }

    transport_mode = KEYBOARD_TRANSPORT_UART;
    return init_split_transport(false);
}

static int init_key_scanning(void)
{
    int ret;

    for (int i = 0; i < KEYBOARD_KEY_COUNT; i++) {
        ret = gpio_pin_configure_dt(&keys[i], GPIO_INPUT | GPIO_PULL_UP);
        if (ret < 0) {
            LOG_ERR("Failed to configure key %d: %d", i + 1, ret);
            return ret;
        }

        key_irqs[i].index = i;
        k_work_init_delayable(&key_irqs[i].work, key_work_handler);
        gpio_init_callback(&key_irqs[i].callback, key_gpio_callback,
            BIT(keys[i].pin));

        ret = gpio_add_callback(keys[i].port, &key_irqs[i].callback);
        if (ret < 0) {
            LOG_ERR("Failed to add key %d callback: %d", i + 1, ret);
            return ret;
        }

        ret = gpio_pin_interrupt_configure_dt(&keys[i], GPIO_INT_EDGE_BOTH);
        if (ret < 0) {
            LOG_ERR("Failed to enable key %d interrupt: %d", i + 1, ret);
            return ret;
        }
        ret = gpio_pin_get_dt(&keys[i]);
        if (ret < 0) {
            return ret;
        }
        update_key(i, ret != 0);
    }

    return 0;
}

int keyboard_inputs_start_configurator(void)
{
    int ret;

    transport_mode = KEYBOARD_TRANSPORT_CONFIGURATOR;
    keyboard_input_state_reset();
    ret = init_split_transport(true);
    if (ret != 0) {
        return ret;
    }
    return init_key_scanning();
}

int main(void)
{
    int ret;

    bool configure;

    ret = configurator_mode_requested(&configure);
    if (ret < 0) {
        LOG_ERR("Failed to sample configurator boot chord: %d", ret);
        return ret;
    }
    if (configure) {
        configurator_mode_run();
        return 0;
    }

    LOG_INF("Keyboard interrupt setup start");
    k_work_init(&split_events_work, split_events_work_handler);
    k_work_init_delayable(&macro_work, macro_work_handler);

    ret = select_transport_mode();
    if (ret != 0) {
        LOG_ERR("Failed to initialize keyboard transport: %d", ret);
        return ret;
    }

    for (int i = 0; i < LEDS; i++) {
        ret = gpio_pin_configure_dt(&leds[i], GPIO_OUTPUT_INACTIVE);
        if (ret < 0) {
            LOG_ERR("Failed to configure LED %d: %d", i, ret);
            return ret;
        }
    }

    ret = init_key_scanning();
    if (ret != 0) {
        LOG_ERR("Failed to initialize key scanning: %d", ret);
        return ret;
    }

    if (transport_mode == KEYBOARD_TRANSPORT_USB) {
        submit_hid_report_from_runtime();
    }

    // Set initial LED states based on active layers
    update_leds_for_layers();

    LOG_INF("Keyboard interrupts initialized");

    while (1) {
        k_sleep(K_SECONDS(1));
    }

    return 0;
}
