gennartan/ergodox-rp2350/src/custom_layout.c

#include "keyboard_layout.h"

/* Generated layout: custom - 38 keys per half). */
static const struct keyboard_action custom_layers[KEYBOARD_HAND_COUNT][KEYBOARD_MAX_LAYERS][KEYBOARD_KEY_COUNT] = {
    [KEYBOARD_HAND_RIGHT] = {
        [KEYBOARD_LAYER_BASE] = {
            [0] = KB_MOD(HID_KBD_MODIFIER_RIGHT_ALT, HID_KEY_RIGHTBRACE),
            [1] = KB_MOD(HID_KBD_MODIFIER_LEFT_UI, HID_KEY_PAGEUP),
            [2] = KB_KEY(HID_KEY_HOME),
            [3] = KB_KEY(HID_KEY_6),
            [4] = KB_KEY(HID_KEY_Y),
            [5] = KB_KEY(HID_KEY_H),
            [6] = KB_KEY(HID_KEY_N),
            [7] = KB_KEY(HID_KEY_7),
            [8] = KB_KEY(HID_KEY_U),
            [9] = KB_KEY(HID_KEY_J),
            [10] = KB_KEY(HID_KEY_M),
            [11] = KB_MOD(HID_KBD_MODIFIER_RIGHT_ALT, 0),
            [12] = KB_KEY(HID_KEY_8),
            [13] = KB_KEY(HID_KEY_I),
            [14] = KB_KEY(HID_KEY_K),
            [15] = KB_KEY(HID_KEY_COMMA),
            [16] = KB_KEY(HID_KEY_LEFT),
            [17] = KB_KEY(HID_KEY_9),
            [18] = KB_KEY(HID_KEY_O),
            [19] = KB_KEY(HID_KEY_L),
            [20] = KB_KEY(HID_KEY_DOT),
            [21] = KB_KEY(HID_KEY_DOWN),
            [22] = KB_KEY(HID_KEY_0),
            [23] = KB_KEY(HID_KEY_P),
            [24] = KB_KEY(HID_KEY_SEMICOLON),
            [25] = KB_KEY(HID_KEY_SLASH),
            [26] = KB_KEY(HID_KEY_UP),
            [27] = KB_KEY(HID_KEY_RIGHT),
            [28] = KB_MOD(HID_KBD_MODIFIER_RIGHT_SHIFT, 0),
            [29] = KB_KEY(HID_KEY_EQUAL),
            [30] = KB_KEY(HID_KEY_LEFTBRACE),
            [31] = KB_KEY(HID_KEY_BACKSPACE),
            [33] = KB_MO(KEYBOARD_LAYER_SYMBOL),
            [34] = KB_DF(KEYBOARD_LAYER_NAV),
            [35] = KB_TG(KEYBOARD_LAYER_NAV),
            [36] = KB_MO(KEYBOARD_LAYER_SYMBOL),
            [37] = KB_KEY(HID_KEY_ENTER),
        },
        [KEYBOARD_LAYER_NAV] = {
            [3] = KB_KEY(HID_KEY_F6),
            [5] = KB_KEY(HID_KEY_LEFT),
            [7] = KB_KEY(HID_KEY_F7),
            [9] = KB_KEY(HID_KEY_DOWN),
            [12] = KB_KEY(HID_KEY_F8),
            [14] = KB_KEY(HID_KEY_UP),
            [17] = KB_KEY(HID_KEY_F9),
            [19] = KB_KEY(HID_KEY_RIGHT),
            [22] = KB_KEY(HID_KEY_F10),
            [30] = KB_KEY(HID_KEY_F12),
            [31] = KB_KEY(HID_KEY_F11),
            [32] = KB_KEY(HID_KEY_A),
            [34] = KB_DF(KEYBOARD_LAYER_BASE),
        },
        [KEYBOARD_LAYER_SYMBOL] = {
            [9] = KB_MOD(HID_KBD_MODIFIER_LEFT_SHIFT, HID_KEY_RIGHTBRACE),
            [14] = KB_MOD(HID_KBD_MODIFIER_RIGHT_ALT, HID_KEY_6),
            [17] = KB_CONSUMER(HID_CONSUMER_VOLUME_DECREMENT),
            [19] = KB_KEY(HID_KEY_RIGHTBRACE),
            [22] = KB_CONSUMER(HID_CONSUMER_VOLUME_INCREMENT),
            [24] = KB_MOD(HID_KBD_MODIFIER_LEFT_SHIFT, HID_KEY_APOSTROPHE),
        },
        [KEYBOARD_LAYER_FN] = {
            [8] = KB_KEY(HID_KEY_KP_7),
            [9] = KB_KEY(HID_KEY_KP_4),
            [10] = KB_KEY(HID_KEY_KP_1),
            [11] = KB_KEY(HID_KEY_KP_0),
            [12] = KB_KEY(HID_KEY_KPSLASH),
            [13] = KB_KEY(HID_KEY_KP_8),
            [14] = KB_KEY(HID_KEY_KP_5),
            [15] = KB_KEY(HID_KEY_KP_2),
            [16] = KB_KEY(ERGODOX_HID_KEY_KP_DOT),
            [17] = KB_KEY(HID_KEY_KPASTERISK),
            [18] = KB_KEY(HID_KEY_KP_9),
            [19] = KB_KEY(HID_KEY_KP_6),
            [20] = KB_KEY(HID_KEY_KP_3),
            [34] = KB_DF(KEYBOARD_LAYER_BASE),
        },
    },
    [KEYBOARD_HAND_LEFT] = {
        [KEYBOARD_LAYER_BASE] = {
            [1] = KB_KEY(HID_KEY_X),
            [2] = KB_KEY(HID_KEY_S),
            [3] = KB_KEY(HID_KEY_W),
            [4] = KB_KEY(HID_KEY_2),
            [5] = KB_MO(KEYBOARD_LAYER_NAV),
            [6] = KB_KEY(HID_KEY_C),
            [7] = KB_KEY(HID_KEY_D),
            [8] = KB_KEY(HID_KEY_E),
            [9] = KB_KEY(HID_KEY_3),
            [10] = KB_MOD(HID_KBD_MODIFIER_LEFT_ALT, 0),
            [11] = KB_KEY(HID_KEY_V),
            [12] = KB_KEY(HID_KEY_F),
            [13] = KB_KEY(HID_KEY_R),
            [14] = KB_KEY(HID_KEY_4),
            [15] = KB_KEY(HID_KEY_B),
            [16] = KB_KEY(HID_KEY_G),
            [17] = KB_KEY(HID_KEY_T),
            [18] = KB_KEY(HID_KEY_5),
            [19] = KB_KEY(HID_KEY_END),
            [20] = KB_MOD(HID_KBD_MODIFIER_LEFT_UI, HID_KEY_PAGEDOWN),
            [21] = KB_MOD(HID_KBD_MODIFIER_RIGHT_ALT, HID_KEY_LEFTBRACE),
            [22] = KB_MOD(HID_KBD_MODIFIER_LEFT_CTRL, 0),
            [23] = KB_MOD(HID_KBD_MODIFIER_LEFT_SHIFT, 0),
            [24] = KB_KEY(HID_KEY_GRAVE),
            [25] = KB_KEY(HID_KEY_TAB),
            [26] = KB_KEY(HID_KEY_ESC),
            [27] = KB_MOD(HID_KBD_MODIFIER_RIGHT_ALT, ERGODOX_HID_KEY_NON_US_BACKSLASH),
            [28] = KB_KEY(HID_KEY_Z),
            [29] = KB_KEY(HID_KEY_A),
            [30] = KB_KEY(HID_KEY_Q),
            [31] = KB_KEY(HID_KEY_1),
            [32] = KB_KEY(HID_KEY_SPACE),
            [33] = KB_KEY(HID_KEY_DELETE),
            [34] = KB_MOD(HID_KBD_MODIFIER_LEFT_UI, 0),
            [36] = KB_DF(KEYBOARD_LAYER_FN),
            [37] = KB_MOD(HID_KBD_MODIFIER_LEFT_UI, 0),
        },
        [KEYBOARD_LAYER_NAV] = {
            [4] = KB_KEY(HID_KEY_F2),
            [9] = KB_KEY(HID_KEY_F3),
            [14] = KB_KEY(HID_KEY_F4),
            [18] = KB_KEY(HID_KEY_F5),
            [26] = KB_KEY(HID_KEY_GRAVE),
            [31] = KB_KEY(HID_KEY_F1),
        },
        [KEYBOARD_LAYER_SYMBOL] = {
            [2] = KB_MOD(HID_KBD_MODIFIER_LEFT_SHIFT, ERGODOX_HID_KEY_NON_US_BACKSLASH),
            [7] = KB_MOD(HID_KBD_MODIFIER_RIGHT_ALT, ERGODOX_HID_KEY_NON_US_BACKSLASH),
            [12] = KB_MOD(HID_KBD_MODIFIER_RIGHT_ALT, HID_KEY_BACKSLASH),
            [18] = KB_KEY(HID_KEY_MINUS),
            [20] = KB_KEY(HID_KEY_END),
            [21] = KB_MOD(HID_KBD_MODIFIER_RIGHT_ALT, HID_KEY_RIGHTBRACE),
            [29] = KB_KEY(ERGODOX_HID_KEY_NON_US_BACKSLASH),
        },
        [KEYBOARD_LAYER_FN] = {
        },
    },
};

static const struct keyboard_layout custom_layout = {
    .name = "custom",
    .layer_count = KEYBOARD_LAYER_COUNT,
    .default_layer = KEYBOARD_LAYER_BASE,
    .layers = &custom_layers,
};
