gennartan/ergodox-rp2350/src/configurator_network.h

#ifndef ERGODOX_CONFIGURATOR_NETWORK_H
#define ERGODOX_CONFIGURATOR_NETWORK_H

/* Start the USB network, DHCP server, and read-only layout HTTP service. */
int configurator_network_start(void);

#endif
