gennartan/ergodox-rp2350/(commit log)

2026-04-09 Initialize keyboard from example
    Example from zephyrproject sample
2026-05-01 Add basic LEDs control
2026-05-01 Add support for UART debug probe
2026-05-01 Configure GPIO interrupt instead of matrix scanning
    This allows to have a better detection of GPIO updates.
2026-05-02 Control LEDs with layer activation
2026-05-15 Add current custom layout
2026-05-31 Disable UART for debugging
2026-05-31 Add hand selection from configuration
    Add the possibility to build for left or right hand. Doing it at build
    time ensures that once flashed, the keyboard will keep its
    configuration and that not runtime error could make it uncontrollable.
    [main.c]
2026-05-31 Fix GPIO position of right column for right hand
    It was inverted. Up was down, down was up...
    [custom_layout.c, keyboard_configurator.py]
2026-05-31 Fix: change left alt keypress to left alt modifier
    Otherwise it is not used as a modifier when actually pressed.
    [custom_layout.c]
2026-05-31 Feat: configure UART bus communication between each keyboard part
    At startup, the keyboard part will detect whether it has a USB
    connection or not. If yes, it will act as the main part and merge
    received report from UART into a USB HID report sent to the host. If
    not, it will send all key pressed into a custom UART report for the main
    part.
    This finally allows to use both keyboard parts together.
    This design also allows easi cable management as each part can be the
    master connected to the USB bus.
2026-06-01 fix: change font color to avoid black on black text
    Including the following texts:
    - Contextual menus (save json, ...)
    - Layers tabs (nav, base, ...)
    - Modifiers checkboxes
    [keyboard_configurator.py]
2026-06-01 Feat: send key pressed instead of HID report over UART
    This allows to change the layer of one part by pressing the other part
    layer switch key.
2026-06-01 Fix right tumb layer change should switch to symbol layer
    [custom_layout.c]
2026-06-07 Add STL files for printing the case
    [righthand_bot_2.stl, righthand_plate_2.stl, righthand_top_2.stl]
2026-06-07 Integrate kicad project into repository
    This contains 3 sub-projects
    * ErgodoxCustom: That was the initial project
    * Left hand: taken from the initial project to have a custom PCB for the
    left hand
    * Right hand: idem
    [ErgoDoxCustom.kicad_pcb, ErgoDoxCustom.kicad_sch, LeftHand.kicad_pcb, LeftHand.kicad_sch, LeftHand_bom.csv, LeftHand_designators.csv, LeftHand_positions.csv, RightHand.kicad_pcb]
2026-11-01 Add a portable Docker build environment for Zephyr 4.5
    Provide an Ubuntu 26.04 image with west 1.5.0, the official Zephyr
    v4.5.0 release, RP2350 modules, and Zephyr SDK 1.0.1 with the ARM
    GNU toolchain.
    Add an entrypoint that builds both keyboard halves from a repository
    mounted at /workspace, writes outputs to build/docker, and supports
    clean builds and interactive shells. Configure writable caches for
    non-root users and use the current m33_0 board qualifier.
    Adapt the split UART interrupt loop to Zephyr 4.5, where
    uart_irq_update() returns void.
2026-11-01 Add segger RTT log backend
    This allows to get the board logs in a terminal and help with
    development
2026-11-02 configurator: add keyboar layout option in persistent NVM
    This will allow to choose the keyboard layout so that the web
    configurator shows the correct configuration. This is only a placeholder
    for now, the actual mapping will be downloaded in a future commit.
    [keyboard_config.c, keyboard_config.h, keyboard_config_store.c]
2026-11-02 Use keyboard layouts from gennartan/layouts
    It includes much more keyboards layouts.
    [xkb-catalog.tsv]
